AlexFigas/Didactic-Robot-Project/docs/college/02_Desenho/Casos de utilizacao.png

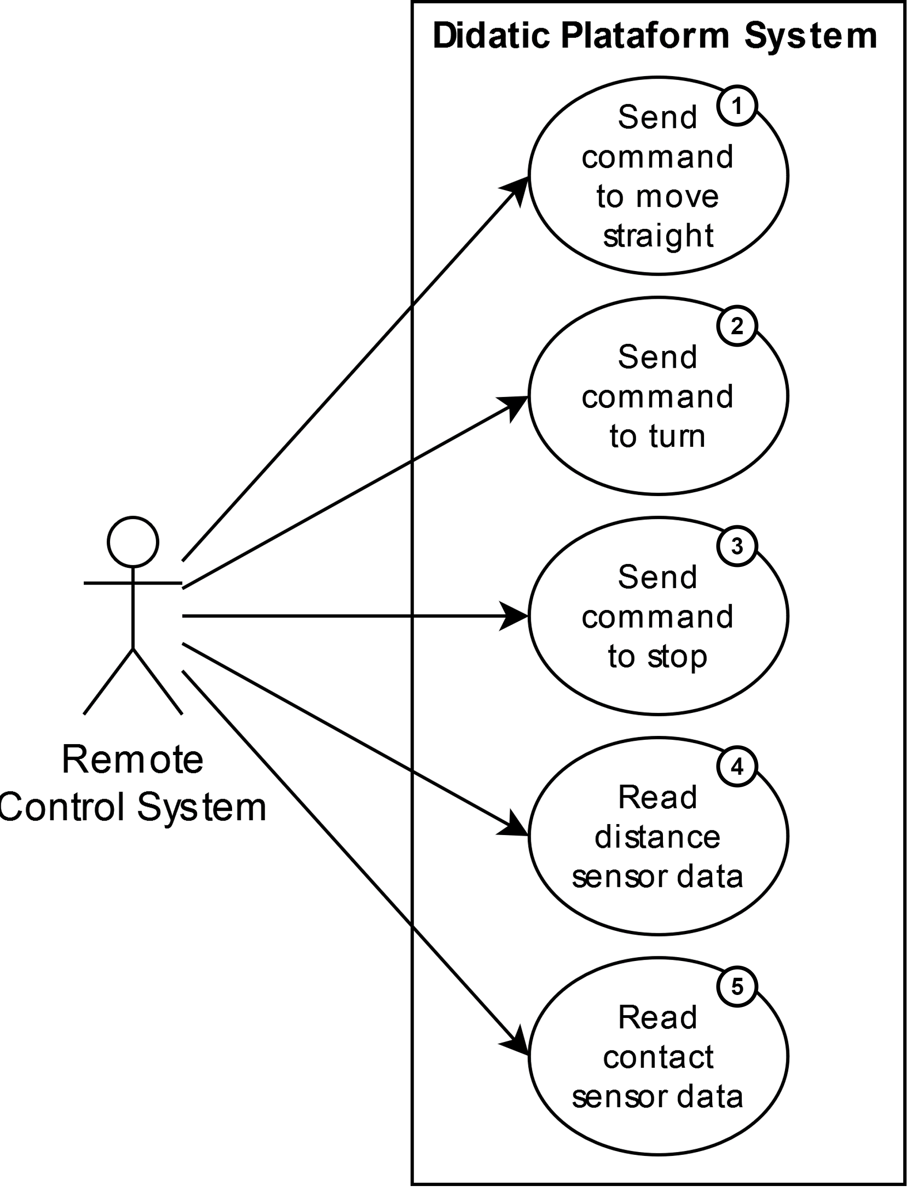
docs/college/02_Desenho/Casos de utilizacao.png
