AlexFigas/Didactic-Robot-Project/docs/college/02_Desenho/Diagrama abstrato.png

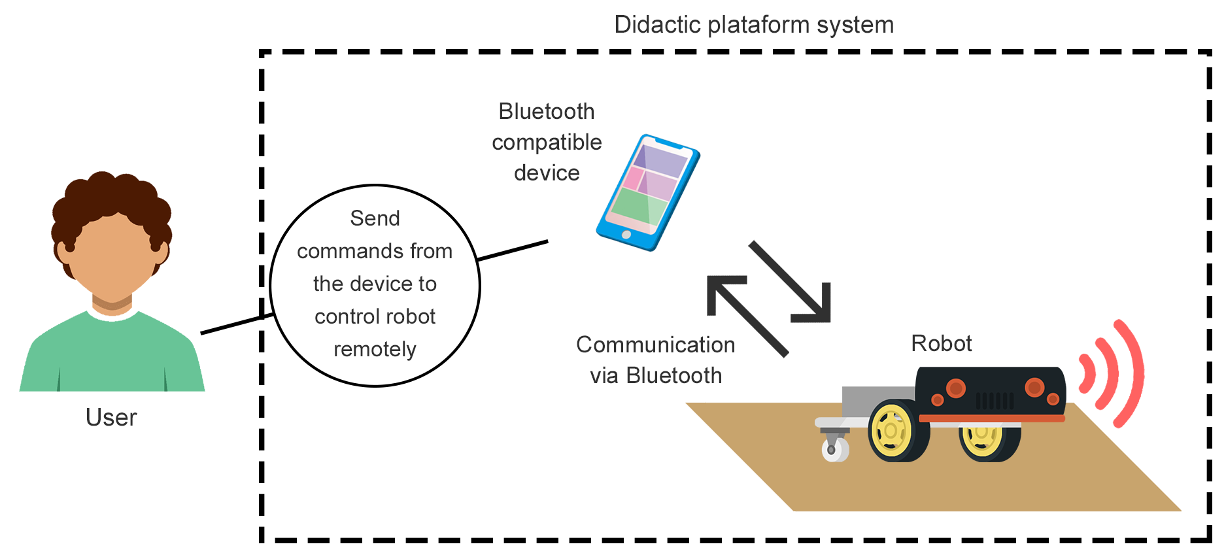
docs/college/02_Desenho/Diagrama abstrato.png
