AlexFigas/Didactic-Robot-Project/docs/college/02_Desenho/Diagrama de Classes Completo.png

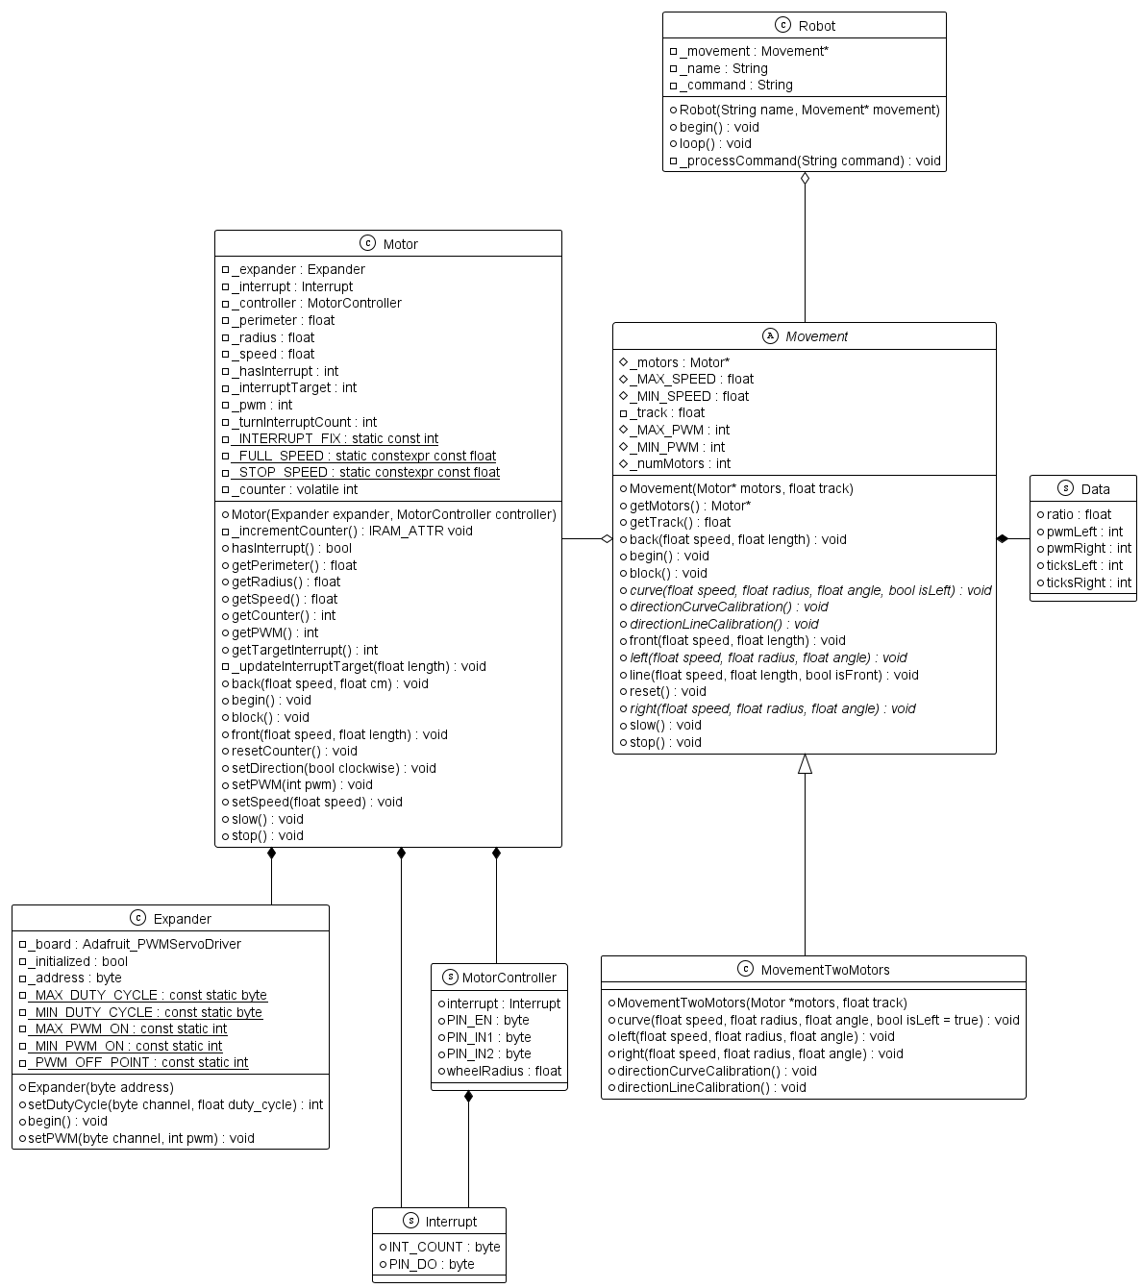
docs/college/02_Desenho/Diagrama de Classes Completo.png
