AlexFigas/Didactic-Robot-Project/docs/college/02_Desenho/Diagrama de Classes Simplificado.png

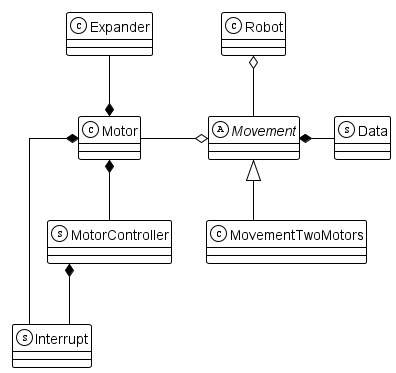
docs/college/02_Desenho/Diagrama de Classes Simplificado.png
