AlexFigas/Didactic-Robot-Project/docs/college/02_Desenho/Diagrama de uma curva à esquerda.png

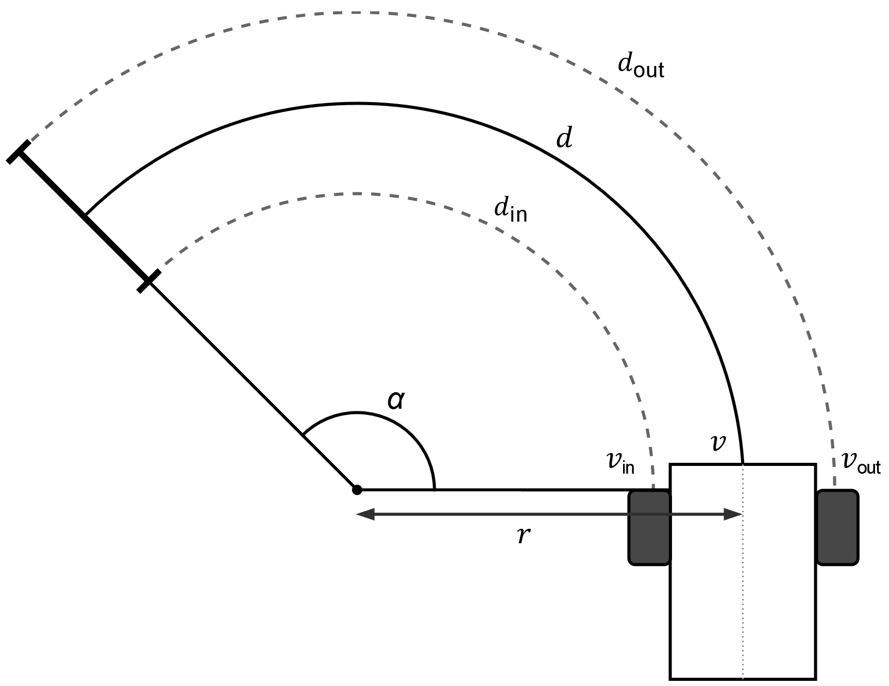
docs/college/02_Desenho/Diagrama de uma curva à esquerda.png
