AlexFigas/Didactic-Robot-Project/docs/college/02_Desenho/Diagrama do sistema em blocos.png

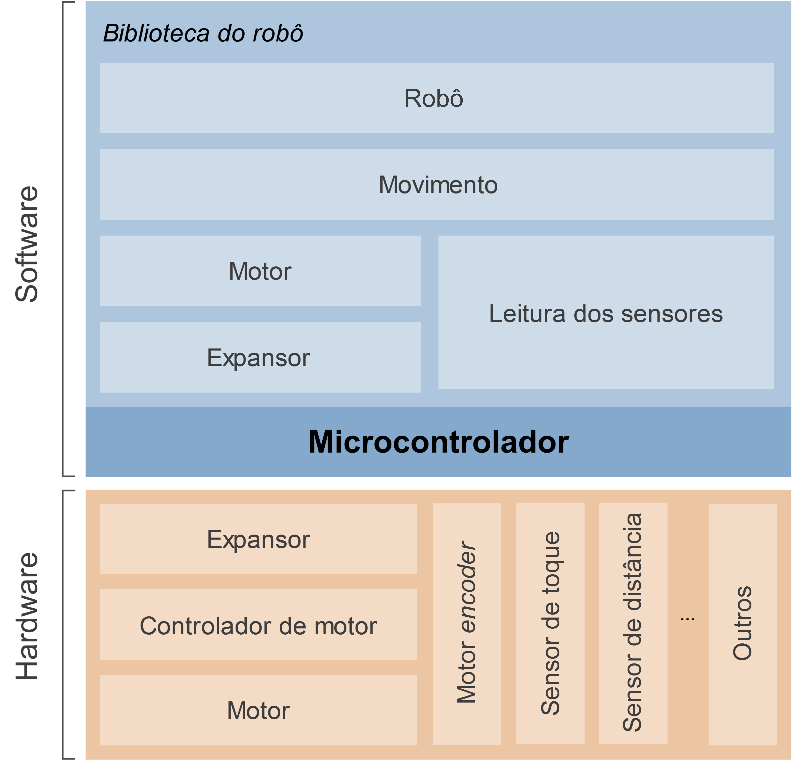
docs/college/02_Desenho/Diagrama do sistema em blocos.png
