AlexFigas/Didactic-Robot-Project/docs/college/02_Desenho/Diagrama ilustrativo do circuito.png

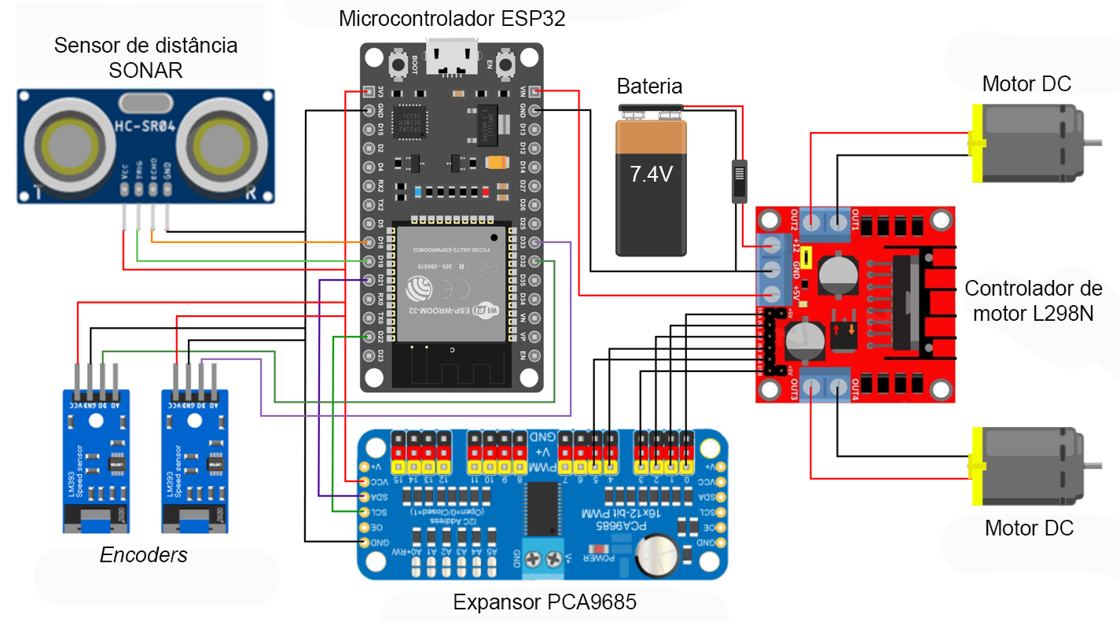
docs/college/02_Desenho/Diagrama ilustrativo do circuito.png
