AlexFigas/Didactic-Robot-Project/docs/college/02_Desenho/Esquema elétrico do prótrotipo.png

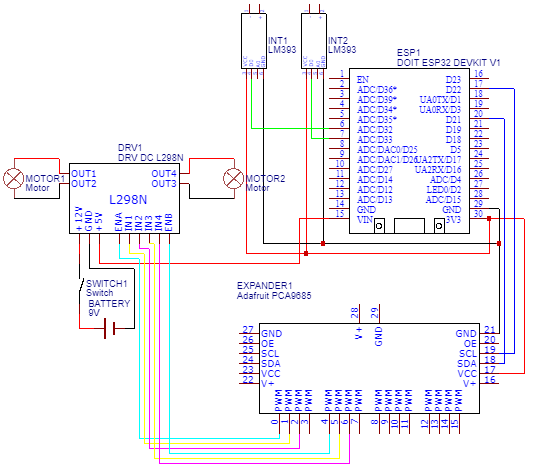
docs/college/02_Desenho/Esquema elétrico do prótrotipo.png
