AlexFigas/Didactic-Robot-Project/docs/college/02_Desenho/Layout da PCB.png

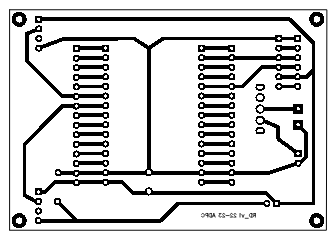
docs/college/02_Desenho/Layout da PCB.png
