AlexFigas/Didactic-Robot-Project/docs/college/03_Implementacao/BOM_Robot_Didatico.xlsx

Sheet: Prototipo
Nome Completo | Link | Nome Simples | Preço | Quantidade:
Kit para carro Robôt 2WD c/ motores e rodas + sup. de pilhas - JOY-IT | https://mauser.pt/catalog/product_info.php?products_id=096-7641 | Kit para carro | 14.90 € | 1
Motor com roda para carros robóticos - JOY-IT | https://mauser.pt/catalog/product_info.php?products_id=096-7645 | Motor | 3.44 € | 2
Gens Ace Soaring Mini 2200mAh 7.4V 20C 2S1P Lipo Battery Pack with XT60 Plug | https://www.svmodelismo.net/pt/lipo/4769-gens-ace-soaring-mini-2200mah-74v-20c-2s1p-lipo-battery-pack-with-xt60-plug.html | Bateria | 8.05 € | 1
Módulo sensor de velocidade por infravermelhos (LM393) para Arduino - Whadda WPSE347 | https://mauser.pt/catalog/product_info.php?products_id=096-3881 | Encoder | 8.14 € | 2
Módulo controlador de 2 motores DC ou 1 Stepper (L298N) compatível c/ Raspberry e Arduino - JOY-IT MotoDriver 2 | https://mauser.pt/catalog/product_info.php?products_id=096-6807 | Controlador de Motor | 2.15 € | 1
Sensor ultrassónico (HC-SR04) compatível com Arduino | https://mauser.pt/catalog/product_info.php?products_id=096-6220 | SONAR | 2.25 € | 1
Kit Microswitch com 5 patilhas substituiveis (IP40) SPDT 250VAC 16A | https://mauser.pt/catalog/product_info.php?cPath=324_1401_707&products_id=010-1429 | Sensor de Toque | 3.46 € | 2
Módulo NodeMCU ESP32 (Wifi+Bluetooth+SRAM) - JOY-IT | https://mauser.pt/catalog/product_info.php?products_id=096-7620 | Microcontrolador | 15.35 € | 1
16-Canais 12-bit PWM/Servo Driver - I2C interface - PCA9685 | https://www.botnroll.com/pt/controladores/3681-16-channel-12-bit-pwm-servo-driver-i2c-interface-pca9685.html | Expansor | 13.40 € | 1 | Total
Costum Printed Circuit Board | - | PCB | 0.80 € | 1 | 86.98

Sheet: Producao
Nome Completo | Link | Nome Simples | Preço | Quantidade:
Kit para carro Robôt 2WD c/ motores e rodas + sup. de pilhas - JOY-IT | https://mauser.pt/catalog/product_info.php?products_id=096-7641 | Kit para carro | 11.92 € | 1000
Motor com roda para carros robóticos - JOY-IT | https://mauser.pt/catalog/product_info.php?products_id=096-7645 | Motor | 2.75 € | 2000
Gens Ace Soaring Mini 2200mAh 7.4V 20C 2S1P Lipo Battery Pack with XT60 Plug | https://www.svmodelismo.net/pt/lipo/4769-gens-ace-soaring-mini-2200mah-74v-20c-2s1p-lipo-battery-pack-with-xt60-plug.html | Bateria | 6.44 € | 1000
Módulo sensor de velocidade por infravermelhos (LM393) para Arduino - Whadda WPSE347 | https://mauser.pt/catalog/product_info.php?products_id=096-3881 | Encoder | 6.51 € | 2000
Módulo controlador de 2 motores DC ou 1 Stepper (L298N) compatível c/ Raspberry e Arduino - JOY-IT MotoDriver 2 | https://mauser.pt/catalog/product_info.php?products_id=096-6807 | Controlador de Motor | 1.72 € | 1000
Sensor ultrassónico (HC-SR04) compatível com Arduino | https://mauser.pt/catalog/product_info.php?products_id=096-6220 | SONAR | 1.80 € | 1000
Kit Microswitch com 5 patilhas substituiveis (IP40) SPDT 250VAC 16A | https://mauser.pt/catalog/product_info.php?cPath=324_1401_707&products_id=010-1429 | Sensor de Toque | 2.77 € | 2000
Módulo NodeMCU ESP32 (Wifi+Bluetooth+SRAM) - JOY-IT | https://mauser.pt/catalog/product_info.php?products_id=096-7620 | Microcontrolador | 12.28 € | 1000
16-Canais 12-bit PWM/Servo Driver - I2C interface - PCA9685 | https://www.botnroll.com/pt/controladores/3681-16-channel-12-bit-pwm-servo-driver-i2c-interface-pca9685.html | Expansor | 10.72 € | 1000 | Total 1000 | Total 1
Custom Printed Circuit Board | - | PCB | 0.22 € | 1000 | 69168 | 69.168
