AlexFigas/Didactic-Robot-Project/docs/college/03_Implementacao/Projeto PCB/BOM_PCB_v3_2023-07-12.csv

ID | Name | Designator | Footprint | Quantity | Manufacturer Part | Manufacturer | Supplier | Supplier Part | Price | Pins | 3DModel | Contributor | image | link
1 | + BAT | J4 | HDR-M-2.54_1X1 | 1 |  |  | LCSC | C81276 | 0.007 | 1 | HDR-M-2.54_1x1 | LCEDA_Lib
2 | - BAT | J5 | HDR-M-2.54_1X1 | 1 |  |  | LCSC | C81276 | 0.007 | 1 | HDR-M-2.54_1x1 | LCEDA_Lib
3 | HDR-M-2.54_1x15 | J6,J7,J1,J2 | HDR-M-2.54_1X15 | 4 |  |  | LCSC | C124373 | 0.103 | 15 | HDR-M-2.54_1x15 | LCEDA_Lib
4 | 47uF | C1 | CAP-D12.5×F5.0 | 1 |  |  |  |  |  | 2 | CAP-D12.5×H20.0×F5.0 | LCEDA_Lib
5 | Left | H1 | HDR-F-2.54_1X4 | 1 |  |  | LCSC | C225501 | 0.072 | 4 | HDR-F-2.54_1x4 | LCEDA_Lib
6 | Right | H2 | HDR-F-2.54_1X4 | 1 |  |  | LCSC | C225501 | 0.072 | 4 | HDR-F-2.54_1x4 | LCEDA_Lib
7 | Expander | H3 | HDR-F-2.54_1X6 | 1 |  |  | LCSC | C40877 | 0.071 | 6 | HDR-F-2.54_1x6 | LCEDA_Lib
8 | Power 5V | H5 | HDR-F-2.54_1X2 | 1 |  |  | LCSC | C49661 | 0.035 | 2 | HDR-F-2.54_1x2 | LCEDA_Lib
9 | Power Bridge H | H6 | HDR-F-2.54_1X2 | 1 |  |  | LCSC | C49661 | 0.035 | 2 | HDR-F-2.54_1x2 | LCEDA_Lib
10 | HDR-M-2.54_1x6 | J3 | HDR-M-2.54_1X6 | 1 |  |  | LCSC | C190819 | 0.034 | 6 | HDR-M-2.54_1x6 | LCEDA_Lib
11 | SS-12F44-G5 | SW3 | SW-TH_SS-12F44-G5 | 1 | SS-12F44-G5 | Rectangular Connectors - Contacts | LCSC | C136718 | 0.078 | 5 | SW-TH_SS-12F44-G5 | LCSC |  | https://item.szlcsc.com/148034.html
