AlexFigas/Didactic-Robot-Project/docs/college/04_Teste/Caracterizacao_dos_motores.xlsx

Rodas no ar - 5 segundos
Duty cycle | Teste 1 |  | Teste 2 |  | Teste 3 |  | Média
 | Esq. | Dir. | Esq. | Dir. | Esq. | Dir. | Esq. | Dir.
10 | Não arrancou |  |  |  |  |  | 0 | 0
20 | Não arrancou |  |  |  |  |  | 0 | 0
30 | Não arrancou |  |  |  |  |  | 0 | 0
40 | Não arrancou |  |  |  |  |  | 0 | 0
50 | 586 | 555 | 585 | 561 | 583 | 557 | 584.6666667 | 557.6666667
60 | 665 | 640 | 668 | 642 | 666 | 640 | 666.3333333 | 640.6666667
70 | 725 | 697 | 723 | 699 | 720 | 696 | 722.6666667 | 697.3333333
80 | 763 | 744 | 760 | 743 | 762 | 746 | 761.6666667 | 744.3333333
90 | 791 | 782 | 793 | 784 | 790 | 783 | 791.3333333 | 783
100 | 860 | 852 | 856 | 853 | 849 | 851 | 855 | 852
No chão - 5 segundos
Duty cycle | Teste 1 |  | Teste 2 |  | Teste 3 |  | Média
 | Esq. | Dir. | Esq. | Dir. | Esq. | Dir. | Esq. | Dir.
10 | Não arrancou |  |  |  |  |  | 0 | 0
20 | Não arrancou |  |  |  |  |  | 0 | 0
30 | Não arrancou |  |  |  |  |  | 0 | 0
40 | Não arrancou |  |  |  |  |  | 0 | 0
50 | 640 | 643 | 638 | 638 | 639 | 638 | 639 | 639.6666667
60 | 643 | 643 | 639 | 638 | 635 | 634 | 639 | 638.3333333
70 | 660 | 658 | 653 | 654 | 652 | 649 | 655 | 653.6666667
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
