AlexFigas/Didactic-Robot-Project/docs/college/04_Teste/Compensador.xlsx

Sheet: 50
index | pwmLeft | pwmRight | ticksLeft | ticksRight | ratio
0 | 0 | 0 | 0 | 0 | 0
1 | 2048 | 2048 | 5 | 5 | 1
2 | 2048 | 2048 | 7 | 7 | 1
3 | 3072 | 2048 | 9 | 10 | 1.5
4 | 2560 | 2389 | 13 | 13 | 1.333333
5 | 2560 | 2389 | 16 | 16 | 1
6 | 2133 | 2787 | 20 | 19 | 1.333333
7 | 2488 | 2322 | 23 | 23 | 1.333333
8 | 2488 | 2322 | 27 | 27 | 1
9 | 2488 | 2322 | 31 | 31 | 1
10 | 2488 | 2322 | 35 | 35 | 1
11 | 2177 | 2612 | 40 | 39 | 1.25
12 | 2177 | 2612 | 44 | 43 | 1
13 | 2048 | 3081 | 49 | 47 | 1.25
14 | 2304 | 2695 | 53 | 52 | 1.25
15 | 2304 | 2695 | 58 | 57 | 1
16 | 2048 | 3063 | 63 | 61 | 1.25
17 | 2304 | 2680 | 67 | 66 | 1.25
18 | 2592 | 2345 | 71 | 71 | 1.25
19 | 2268 | 2638 | 76 | 75 | 1.25
20 | 2268 | 2638 | 81 | 80 | 1
21 | 2551 | 2308 | 85 | 85 | 1.25
22 | 2232 | 2596 | 90 | 89 | 1.25
23 | 2232 | 2596 | 95 | 94 | 1
24 | 2048 | 3015 | 100 | 98 | 1.25
25 | 2304 | 2638 | 104 | 103 | 1.25
26 | 2304 | 2638 | 109 | 108 | 1
27 | 2304 | 2638 | 113 | 112 | 1
28 | 2304 | 2638 | 118 | 117 | 1
29 | 2304 | 2638 | 123 | 122 | 1
30 | 2304 | 2638 | 128 | 127 | 1
31 | 2048 | 2999 | 133 | 131 | 1.25
32 | 2304 | 2624 | 137 | 136 | 1.25
33 | 2304 | 2624 | 142 | 141 | 1
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
