AlexFigas/Didactic-Robot-Project/docs/college/03_Implementacao/Esquematica Inicial.pdf

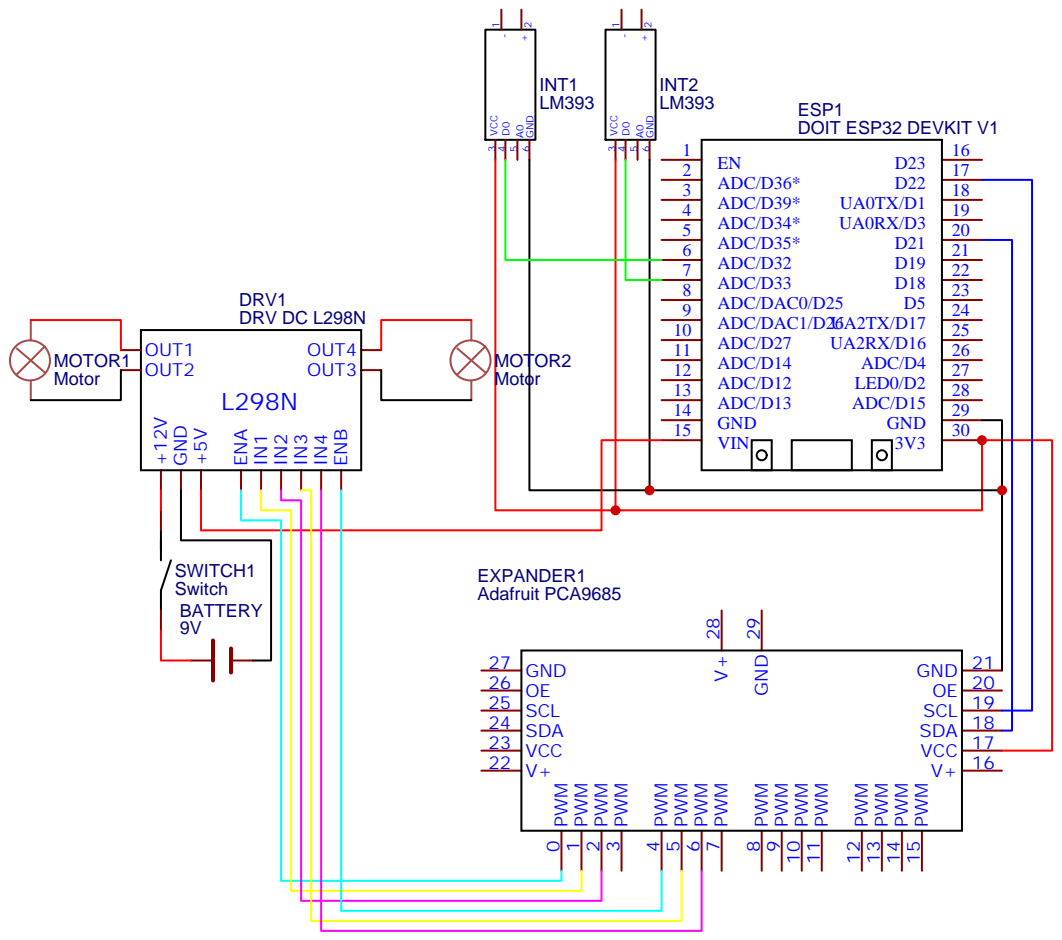
[picture p11: page 1]

V+ 22 VCC 23 SDA 24 SCL 25 OE 26 GND 27

V+ 16 VCC 17 SDA 18 SCL 19 OE 20 GND 21

Drawn By: Alexandre Daniela

## GND

### ThickLeft

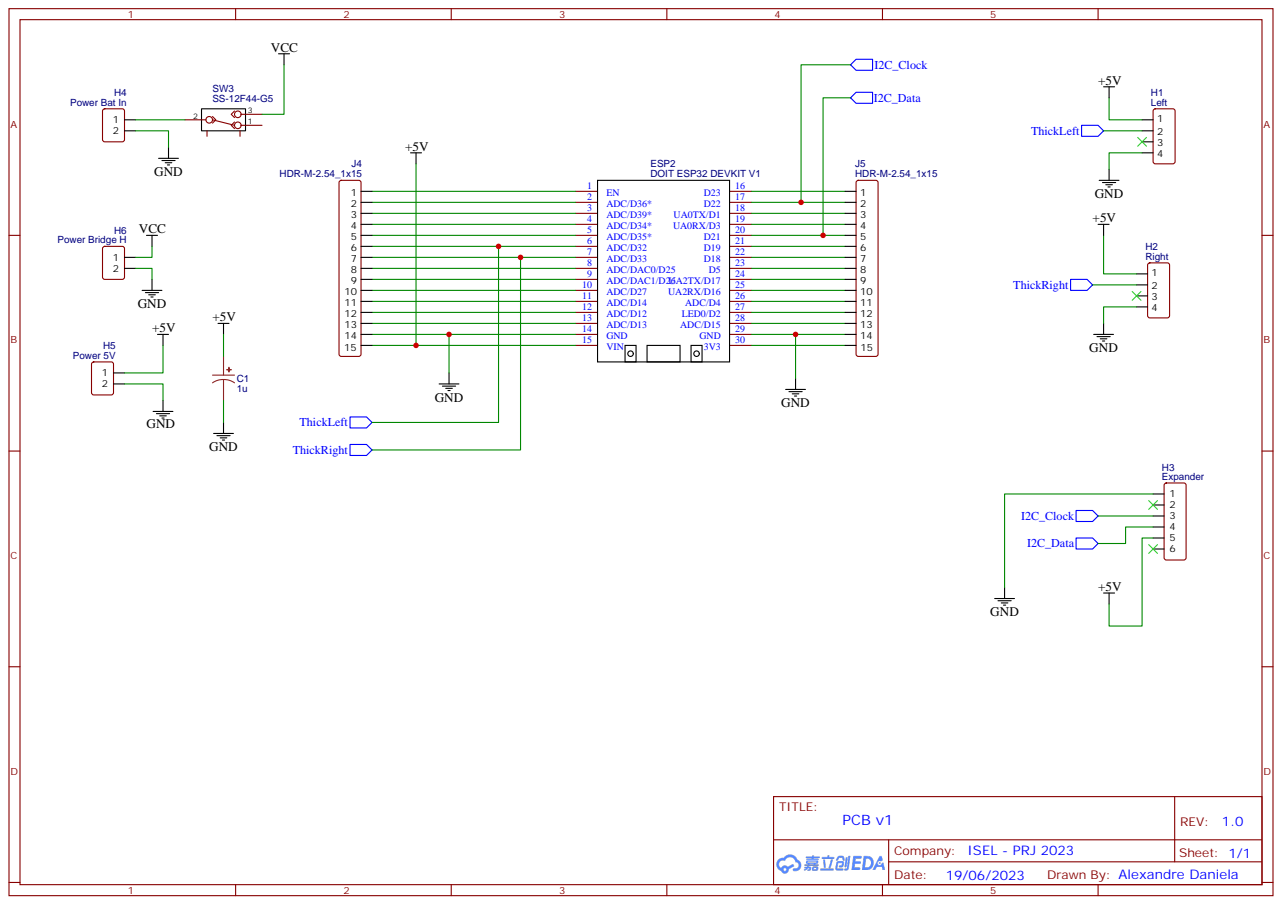
[picture p12: page 2]

Drawn By: Alexandre Daniela
