AlexFigas/Didactic-Robot-Project/docs/college/03_Implementacao/Projeto PCB/Esquematica PCB.pdf

## GND

### ThickLeft

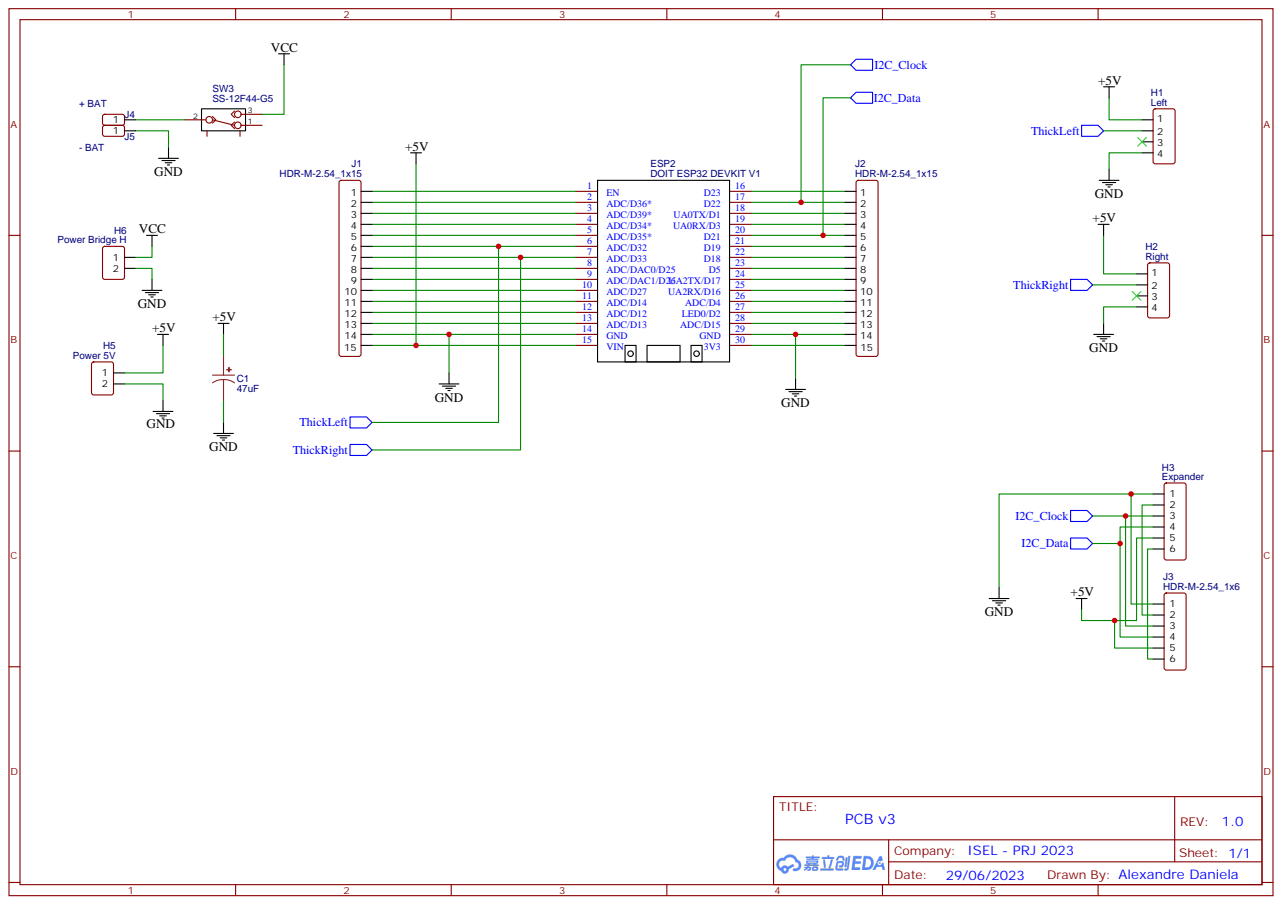
[picture p13: page 1]

Drawn By: Alexandre Daniela
