AlexFigas/Didactic-Robot-Project/docs/college/03_Implementacao/Projeto PCB/Layout PCB.pdf

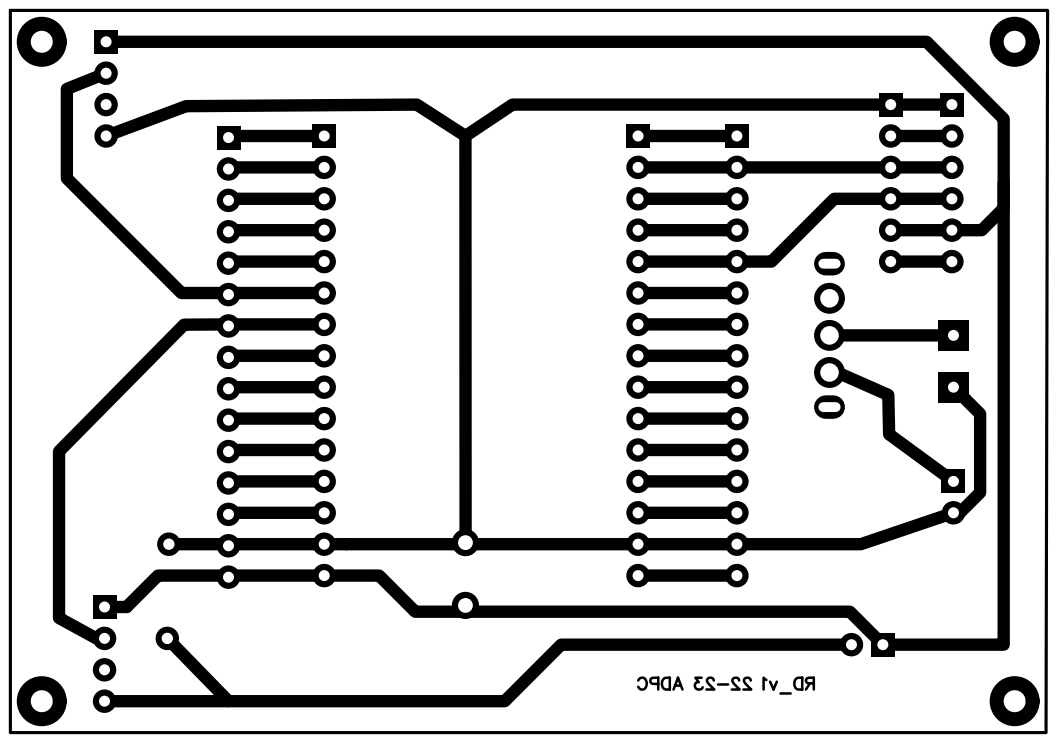
[picture p14: page 1]
