AlexFigas/Didactic-Robot-Project/docs/college/03_Implementacao/Código/src/Robot.h

/**
 * @file Robot.h - Library for controlling the robot.
 *
 * @author Alexandre Figueiredo and Daniela Gonçalves
 */

#ifndef ROBOT_H
#define ROBOT_H
#include <BluetoothSerial.h>
#include <Arduino.h>
#include "Movement.h"

class Robot
{
public:
    Robot(String name, Movement* movement);

    // Public constants

    // Public variables

    // Public methods
    void begin();
    void loop();

private:
    // Private constants

    // Private variables
    Movement* _movement;
    String _name;
    String _command;

    // Private methods
    void _processCommand(String command);
};
#endif
