AlexFigas/Didactic-Robot-Project/(commit log)

2023-03-06 Bluetooth test - ESP32 module
2023-03-06 Added I2CLookup. Comunication via Bluetooth and I2C done.
2023-03-07 Organized code. Added Expander library. Started PWM testing.
2023-03-08 Moved PWMLookup outside Robot. Updated libs and fixed compile errors. Fixed PWM issue. Motors now spin (needs at least 50% duty cycle to start).
    [Expander.cpp, Expander.h]
2023-03-13 Initial Interrupt testing.
2023-03-15 Initial Motor class implementation.
2023-03-16 Trying to implement interrupt in Motor Class.
2023-03-20 Interrupts now can count with multiple motors. Trying to fix 40 interrupts in a lap (should be 20). Commented code.
    [Expander.cpp, Expander.h, Motor.cpp, Motor.h]
2023-03-21 Interrupt problem now "fixed". On change seems to be more accurate.
    [Motor.cpp]
2023-04-07 Robot now turns left and right. Still not doing the correct radius.
    [Movement.cpp, Movement.h, MovementTwoMotors.cpp, MovementTwoMotors.h]
2023-04-14 Left/right calculations with interruptTarget atmpt
2023-05-08 Motor Counter Bug
2023-05-25 Speed compensation and bug fixes
    [Expander.cpp, Expander.h, Motor.cpp, Motor.h, Movement.cpp, Movement.h, MovementTwoMotors.cpp, MovementTwoMotors.h]
2023-06-05 PID Control
2023-06-05 Increase/Decrease both motors
2023-06-05 Increase/Decrease with more samples (better)
2023-06-06 Problema na struct resolvido. Código reformatado.
    [Expander.cpp, Motor.cpp, Motor.h, Movement.cpp, Movement.h, MovementTwoMotors.cpp, MovementTwoMotors.h]
2023-06-15 ___REMOVE___/esptool.exe": CreateProcess error=2, The system cannot find the file specified
    [Motor.h, Movement.cpp, Movement.h]
2023-06-21 Fixed a bug where 4 motors where instantiated instead of 2.
2023-06-27 Bugs fixed (data array clean and PWM limitation)
    [Expander.cpp, Motor.cpp, Motor.h, Movement.cpp, Movement.h, MovementTwoMotors.cpp]
2023-06-30 Code cleaning. Added documentation. Made Movement more generic to work with N motors.
2023-07-11 Release version 1.0
    [BOM_Robot_Didatico.xlsx, Caracterizacao_dos_motores.xlsx, Compensador.xlsx, prj_27_casosUtilizacao.xls, prj_27_requisitos.xls]
2023-07-12 Added PCB Project files.
    [BOM_PCB_v3_2023-07-12.csv, PickAndPlace_PCB_v3_2023-07-12.csv]
2023-07-12 Updated college docs.
    [BOM_PCB_v3_2023-07-12.csv, PickAndPlace_PCB_v3_2023-07-12.csv]
